Anderson69s/Jewel85/Circle/PCB/BOM.xls

BOM Jewel85
Components | Description | Ref PCB | Number | Suppliers | Ref Suppliers | Ref Suppliers 2
MICRO
ATTINY85-20SU | MCU 8 bits, ATtiny, 20 MHz, 8 KB, 512 Byte, 8 Pins, SOIC | UC1 | 1 | RS-Components | 133-1674
POWER
Battery | Lithium Ion Polymer Battery - 3.7v 600mAh | P1, P6 | 1 | Farnell | 2077883
Charge Battery | MCP73831 | U1 | 1 | Farnell | 1332158 | https://fr.aliexpress.com/item/5PCS-MCP73831T-2ACI-OT-SOT23-5-MCP73831T-2ACI-SOT-MCP73831T-MCP73831-SMD-free-shipping/32715288362.html
CAPACITORS
Capacitors for LED | Multilayer Ceramic Capacitor, MC Series, 100 nF, 10%, X7R, 16 V, 0805 | C1, C2,C3, C4, C7, C8 | 4 | Farnell | 1759143 | https://fr.aliexpress.com/item/500pcs-100nF-X7R-Error-10-50V-0805-SMD-Thick-Film-Chip-Multilayer-Ceramic-Capacitor-free-shipping/32812155708.html
Capacitors for POWER | Multilayer Ceramic Capacitor, MC Series, 10 mF, 10%, X7R, 16 V, 0805 | C5, C6 | 4 | Farnell | 2320921 | https://fr.aliexpress.com/item/100pcs-10uF-X5R-Error-10-10V-0805-SMD-Thick-Film-Chip-Multilayer-Ceramic-Capacitor/32812191502.html
RESISTORS
Resistor Configuration | 10K 0805 | R3 | 1 | Farnell | 2447553 | https://fr.aliexpress.com/item/500pcs-0805-SMD-Resistor-1-10K-ohm-1-8W-103/32806586152.html
Resistors for LED | 470 0805 | R1, R2 | 2 | Farnell | 2447662 | https://fr.aliexpress.com/item/500pcs-0805-SMD-Resistor-1-470-ohm-1-8W-470R-471/32806740237.html
LEDS
LED Red | LED, Rouge, CMS, 1.25mm x 1.4mm, 20 mA, 1.85 V, 643 nm | D4 | 1 | Farnell | 2610416 | https://fr.aliexpress.com/item/0805-2012-red-light-light-emitting-diode-SMD-LED-1000pcs-lot/2035206540.html
LED Green | LED, Vert, CMS, 1.25mm x 1.4mm, 20 mA, 2.1 V, 570 nm | D5 | 1 | Farnell | 2099239 | https://fr.aliexpress.com/item/100pcs-Free-shipping-Red-0603-SMD-LED-diodes-light/32320980794.html
LED RGBW | SK6812 Cool | D1, D2, D3, D6, D7 | 3 | Adafruit | 2759 | https://fr.aliexpress.com/item/10-1000pcs-SK6812-RGBW-RGB-Warm-White-5050-SMD-similar-with-WS2812B-Individually-Addressable-Digital-LED/32549663471.html
BUTONS
Push Buton | Tactile Switch, Non Illuminated, 12 V, 50 mA, 320 gf, Solder, DTS Series | Animations | 1 | Farnell | 9471898
Switch ON//OFF | Slide Switch, JS Series, DPDT, Vertical, SMD, 100 mA | ON // OFF | 1 | Farnell | 2320019
CONNECTOR
Charge USB | Connecteur USB, Micro USB Type B, USB 2.0, Embase, 5 Voies, Montage en surface, traversant, Coudée | P2 | 1 | Farnell | 2554981
