Anderson69s/Jewel85/Circle/Case/Case_Rond.FCStd

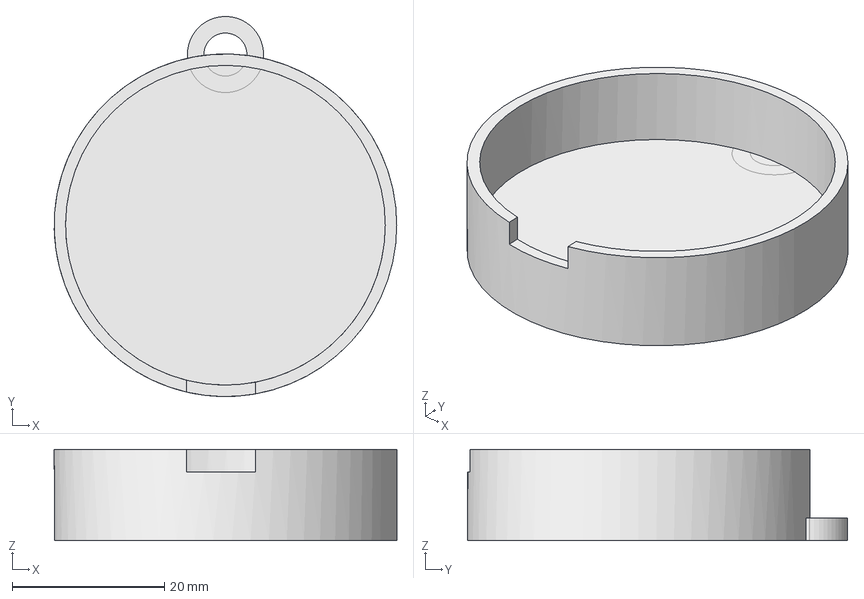
[picture p1: CAD file, 2018-08-06]
Circle/Case/Case_Rond.FCStd
45.0 x 49.9 x 12.0 mm
