Anderson69s/Jewel85/Square/Case/Case_Carre.FCStd

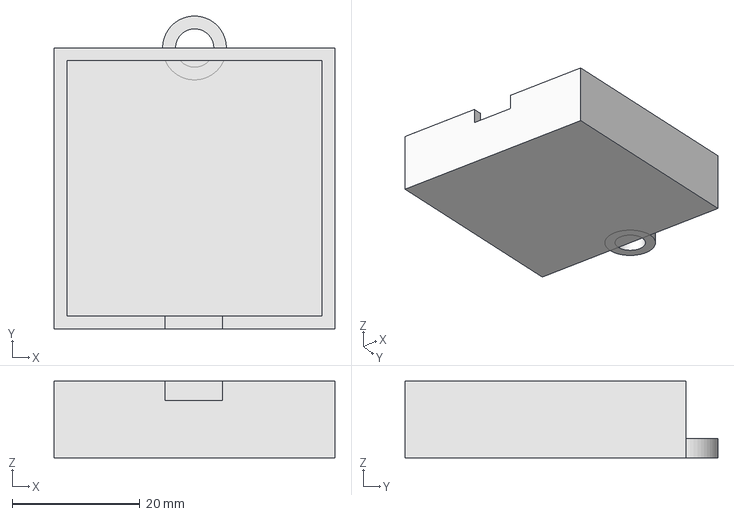
[picture p2: CAD file, 2018-08-06]
Square/Case/Case_Carre.FCStd
44.0 x 49.0 x 12.0 mm
