Anderson69s/Jewel85/(list of files, cad)

Other CAD files:
Circle/Case/Case_Rond.stl
Square/Case/Case_Carre.stl
