Anderson69s/Jewel85/Circle/PCB/Jewel85.sch

## KiCad design Circle/PCB/Jewel85.sch (2018-05-24)

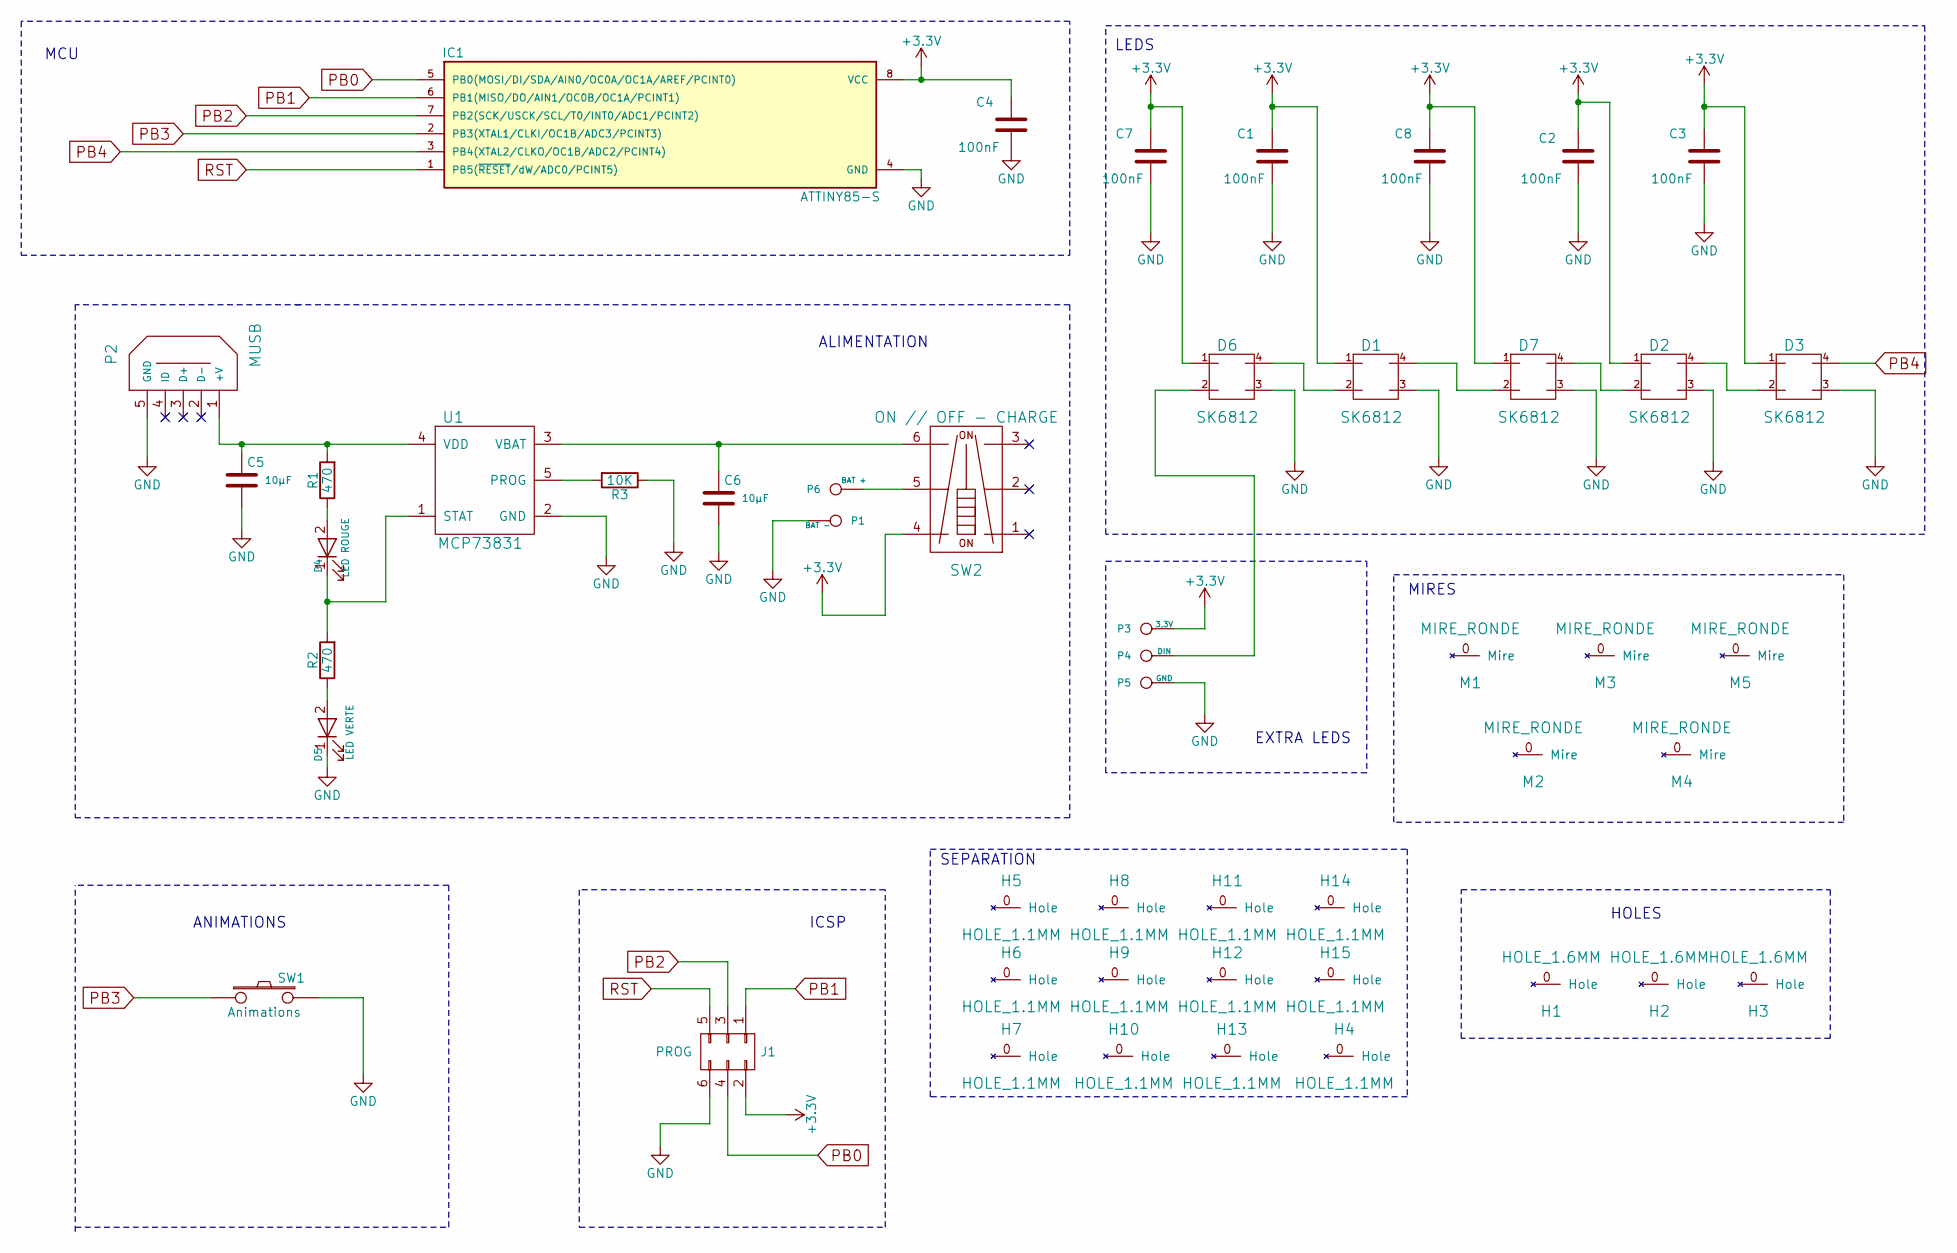
[picture p3: schematic Jewel85.sch]

Parts:
C1, C2, C3, C4, C7, C8: 100nF; SM0805
C5, C6: 10μF; SM0805
D1, D2, D3, D6, D7: SK6812; WS2812B
D4: LED ROUGE; LED_0805
D5: LED VERTE; LED_0805
H1, H2, H3: HOLE_1.6MM; Hole_1.6mm
H4, H5, H6, H7, H8, H9, H10, H11, H12, H13, H14, H15: HOLE_1.1MM; Hole_1.1mm
IC1: ATTINY85-S; SOIC8-W
J1: PROG; Socket_Strip_Straight_2x03_Pitch2.54mm
M1, M2, M3, M4, M5: MIRE_RONDE; Mire_Ronde_1mm
P1: BAT -; PADS_CONNEXION
P2: MUSB; USB_Micro-B
P3: 3,3V; PADS_CONNEXION
P4: DIN; PADS_CONNEXION
P5: GND; PADS_CONNEXION
P6: BAT +; PADS_CONNEXION
R1, R2: 470; SM0805
R3: 10K; SM0805
SW1: Animations; SWITCH_CMS
SW2: ON // OFF - CHARGE; Switch_DPDT_Large
U1: MCP73831; SOT23-5

Connections:
+3.3V: C1.1, C2.1, C3.1, C4.1, C7.1, C8.1, D1.1, D2.1, D3.1, D6.1, D7.1, IC1.8 (VCC), J1.2, P3.1, SW2.4
GND: C1.2, C2.2, C3.2, C4.2, C5.2, C6.2, C7.2, C8.2, D1.3, D2.3, D3.3, D5.1 (K), D6.3, D7.3, IC1.4 (GND), J1.6, P1.1, P2.5 (GND), P5.1, R3.1, SW1.2, U1.2 (GND)
unnamed: C5.1, P2.1 (+V), R1.2, U1.4 (VDD)
unnamed: C6.1, SW2.6, U1.3 (VBAT)
unnamed: D1.2, D6.4
unnamed: D1.4, D7.2
unnamed: D2.2, D7.4
unnamed: D2.4, D3.2
unnamed: D4.1 (K), R2.2, U1.1 (STAT)
unnamed: D4.2 (A), R1.1
unnamed: D5.2 (A), R2.1
unnamed: D6.2, P4.1
unnamed: P6.1, SW2.5
unnamed: R3.2, U1.5 (PROG)
PB0: IC1.5 (PB0(MOSI/DI/SDA/AIN0/OC0A/OC1A/AREF/PCI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), J1.4
PB1: IC1.6 (PB1(MISO/DO/AIN1/OC0B/OC1A/PCINT1)), J1.1
PB2: IC1.7 (PB2(SCK/USCK/SCL/T0/INT0/ADC1/PCINT2)), J1.3
PB3: IC1.2 (PB3(XTAL1/CLKI/OC1B/ADC3/PCINT3)), SW1.1
PB4: D3.4, IC1.3 (PB4(XTAL2/CLKO/OC1B/ADC2/PCINT4))
RST: IC1.1 (PB5(~RESET~/dW/ADC0/PCINT5)), J1.5

Notes on the sheet:
LEDS
MCU
ANIMATIONS
ICSP
HOLES
ALIMENTATION
EXTRA LEDS
MIRES
SEPARATION
