Anderson69s/Jewel85/(commit log)

2018-05-24 1st
    initial commit
    [BOM.xls, Jewel85-2018-05-16-17-29-26.sch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]
2018-05-24 2nd
    add old pcb
    [BOM.xls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]
2018-05-24 3rd
    removed old repo
    [BOM.xls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]
2018-06-26 Square Board
    initial design for square board
    [BOM.xls, Jewel85-2018-05-16-17-29-26.sch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]
2018-07-04 Clean and short
    Cleaning and shorting the repo
    [BOM.xls, Jewel85-2018-05-16-17-29-26.sch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]
2018-08-06 Case
    Add case
    [BOM.xls, Case_Carre.FCStd, Case_Carre.stl, Case_Rond.FCStd, Case_Rond.stl, Jewel85-2018-05-16-17-29-26.sch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]
2018-08-06 Finish case
    Case = Done
2018-11-04 Clean up
    Sort some files
    [Case_Rond.FCStd, Case_Rond.stl]
2019-01-27 Clean UP
    Clean UP
    [BOM.xls, Case_Carre.FCStd, Case_Carre.stl, Case_Rond.FCStd, Case_Rond.stl, Jewel85-2018-05-16-17-29-26.sch, Jewel85-2018-11-04-10-31-18.sch, Jewel85-2019-01-27-19-17-31.sch]
2019-01-30 Forgot Adafruit...
    🙈🙊
